MyRaceData/TRAKBOX/hardware/README.md

# BNO055
Manufacturer: Bosch
## Sources:
Mouser Electronics [bno055 order page](https://www.mouser.com/ProductDetail/Bosch-Sensortec/BNO055?qs=QhAb4EtQfbV8Z2YmISucWw%3D%3D)
## Current price:
bno055 (usd 09.03.2023) 10 x $9.30 Mouser
## Datasheets:
[bno055](https://www.mouser.com/datasheet/2/783/bst_bno055_ds000-3247202.pdf)

# BME280
Manufacturer: Bosch
## Sources:
Mouser Electronics [bme280 order page](https://www.mouser.com/ProductDetail/Bosch-Sensortec/BME280?qs=2OnyuXx6vpj2fK9HX7qb3g%3D%3D)
## Current price:
bme280 (usd 09.03.2023) 10 x $4.07 Mouser
## Datasheets:
[bme280](https://www.mouser.com/datasheet/2/783/bst_bme280_ds002-2238172.pdf)

# Currently sourced from retail
## DS3231 Real Time Clock
Alternate chip with equal functionality could be used
## GPS module
[GT-U7 GPS Module](https://www.amazon.com/Navigation-Positioning-Sensitivity-Consumption-High-Precision/dp/B08ZSMPPP6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)
(amazon 2 x $18.99 usd)
## OLED display
## SC card module
