MyRaceData/TRAKBOX/EasyEDA_Schematic2_RacTrakBox.png

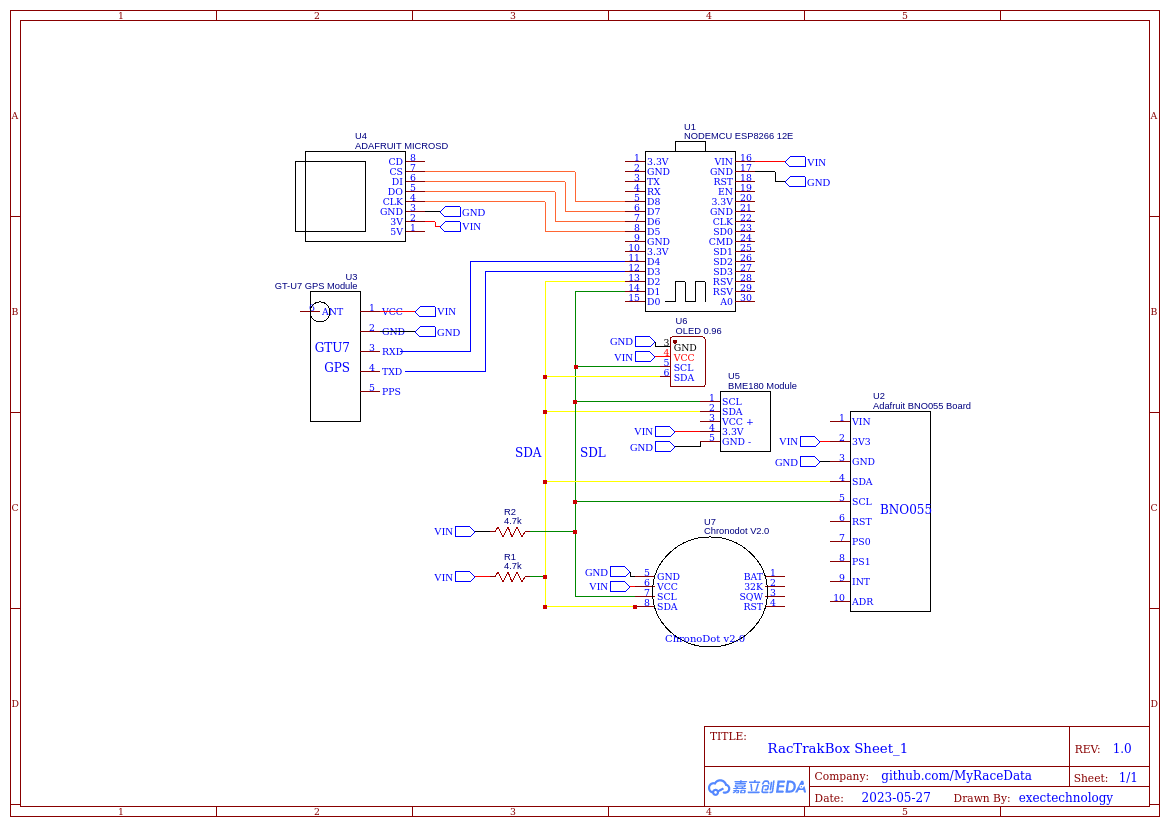
EasyEDA_Schematic2_RacTrakBox.png
