MyRaceData/TRAKBOX/pcb8.30.23V01.png

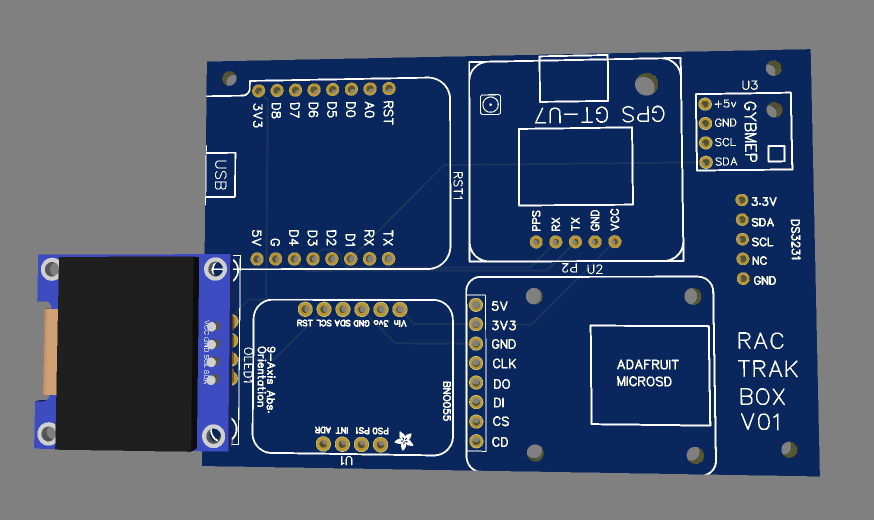
pcb8.30.23V01.png
