MyRaceData/TRAKBOX/hardware/BOM.md

## ESP8266 NodeMCU
  Model: ESP8266 NodeMCU CP2102 ESP-12E Development Board

## BNO055

  Model: Adafruit 9-DOF Absolute Orientation IMU Fusion Breakout - BNO055
  
      [web link](https://www.adafruit.com/product/2472)
  
      Manufacturer Product ID: 2472
      
      Dimensions: 20mm x 27mm x 4mm / 0.8" x 1.1" x 0.2"
      
      -Absolute Orientation (Euler Vector, 100Hz) - Three axis orientation data based on a 360° sphere
      -Absolute Orientation (Quaterion, 100Hz) - Four point quaternion output for more accurate data manipulation
      -Angular Velocity Vector (100Hz) - Three axis of 'rotation speed' in rad/s
      -Acceleration Vector (100Hz) - Three axis of acceleration (gravity + linear motion) in m/s^2
      -Magnetic Field Strength Vector (20Hz) - Three axis of magnetic field sensing in micro Tesla (uT)
      -Linear Acceleration Vector (100Hz) - Three axis of linear acceleration data (acceleration minus gravity) in m/s^2
      -Gravity Vector (100Hz) - Three axis of gravitational acceleration (minus any movement) in m/s^2
      -Temperature (1Hz) - Ambient temperature in degrees celsius
      
dimensional digram
