MyRaceData/TRAKBOX/(commit log)

2023-04-29 Create BOM
2023-05-22 Update and rename BOM to BOM.md
2023-05-27 add prototype photo
2023-05-28 add EasyEDA schematic
2023-09-30 Update README.md
    add schematic pcb v4
2024-01-28 Update TRAKBOX.012.ino
    Correct comments at top of file including notes about wifi connection and add pre-production note
    [TRAKBOX.012.ino]
